hixio-mh/BatteryMeter/Images/3DPrint_PartsBottom.jpg

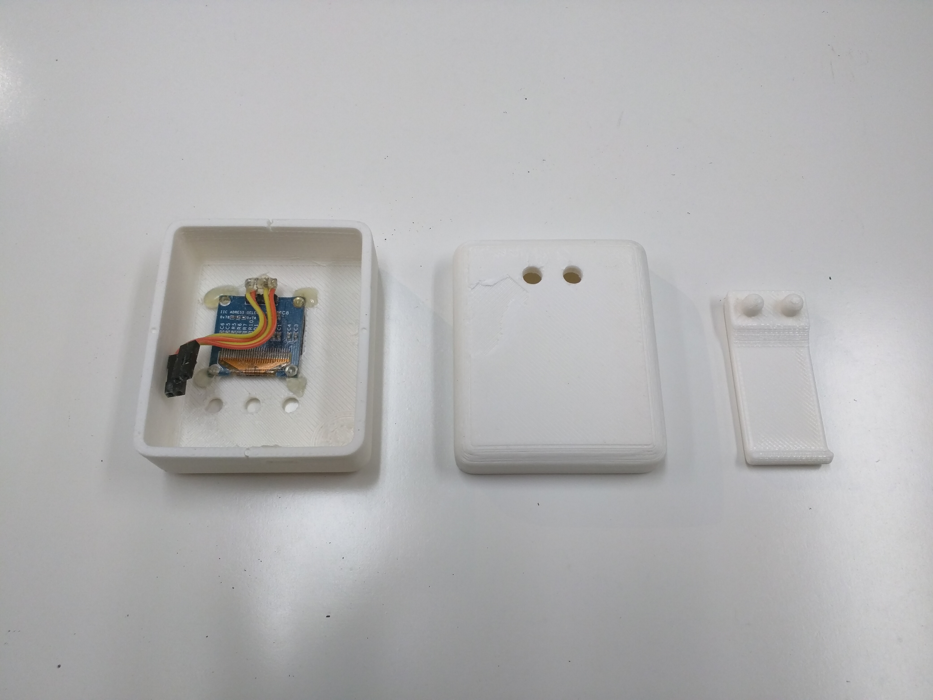
Images/3DPrint_PartsBottom.jpg
