hixio-mh/BatteryMeter/Images/PaperMockup_Bottom.jpg

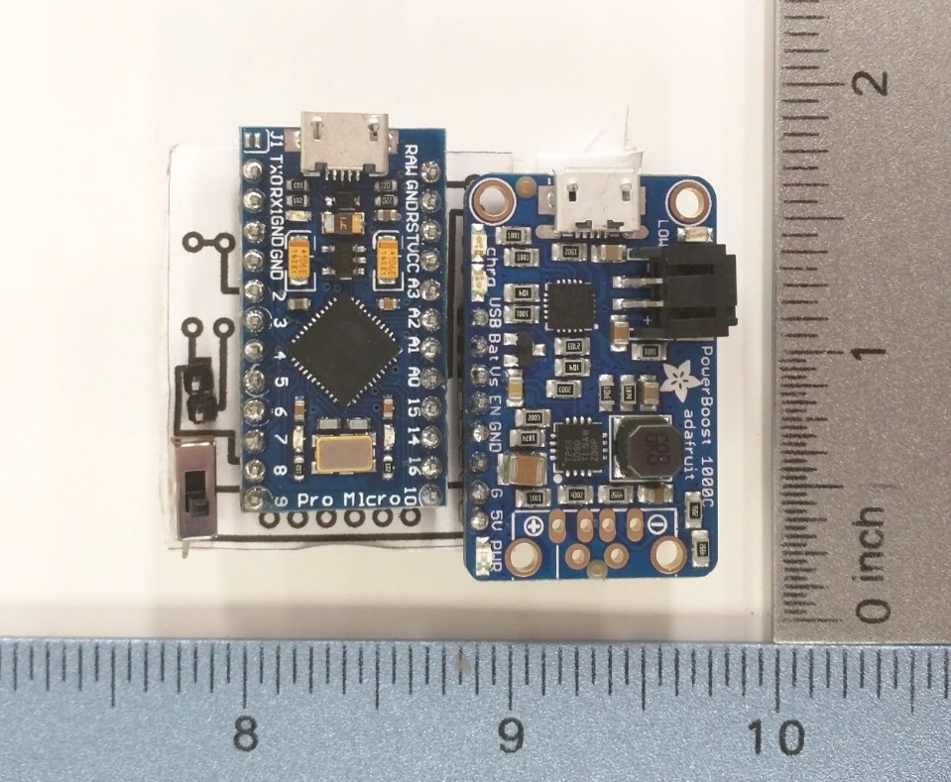
Images/PaperMockup_Bottom.jpg
