hixio-mh/BatteryMeter/README.md

# BatteryMeter
Battery Meter is a graphing voltmeter that allows users to track long-term performance of recharable batteries in handheld devices.
