hixio-mh/BatteryMeter/Documentation/07-FunctionProduction.pdf

### Function Production

Finalized Software
I have included the software in the GitHub repository with the following libraries:
- Adafruit GFX Library (modified)
- Adafruit ILI9341 Library
All code has been commented and I have included an appropriate license for the work.

Printed PCB

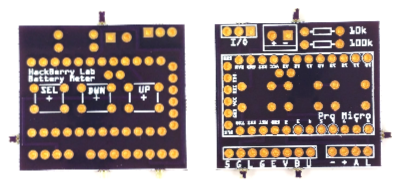
[picture p19: figure]
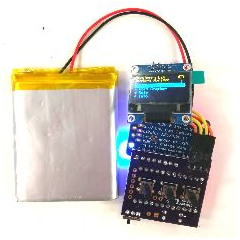
[picture p20: figure]
