hixio-mh/BatteryMeter/Documentation/08-FormProduction.pdf

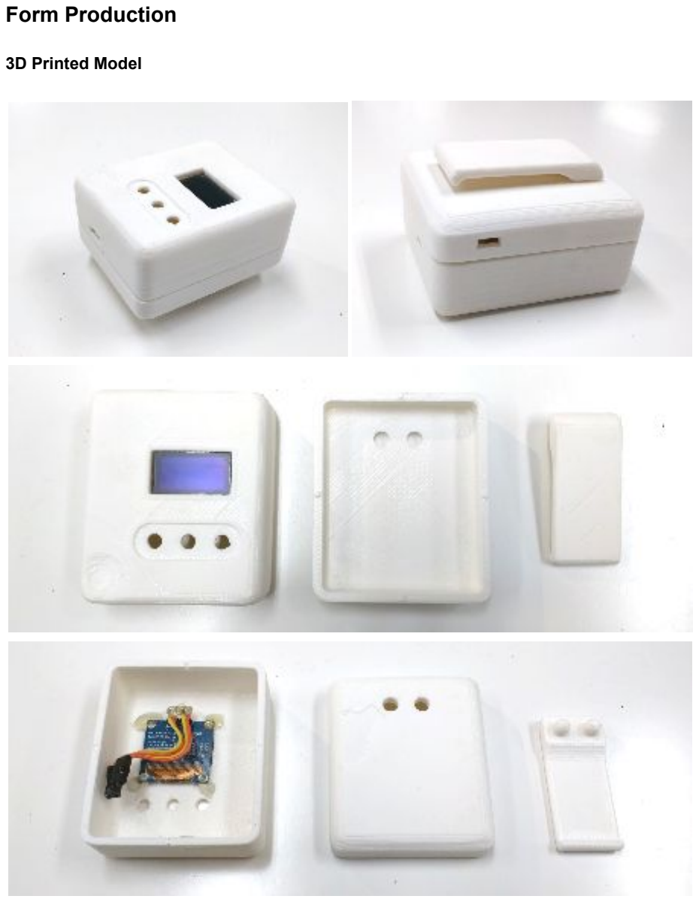
[picture p21: page 1]

### Form Production

3D Printed Model
