hixio-mh/BatteryMeter/Documentation/06-FormProof.pdf

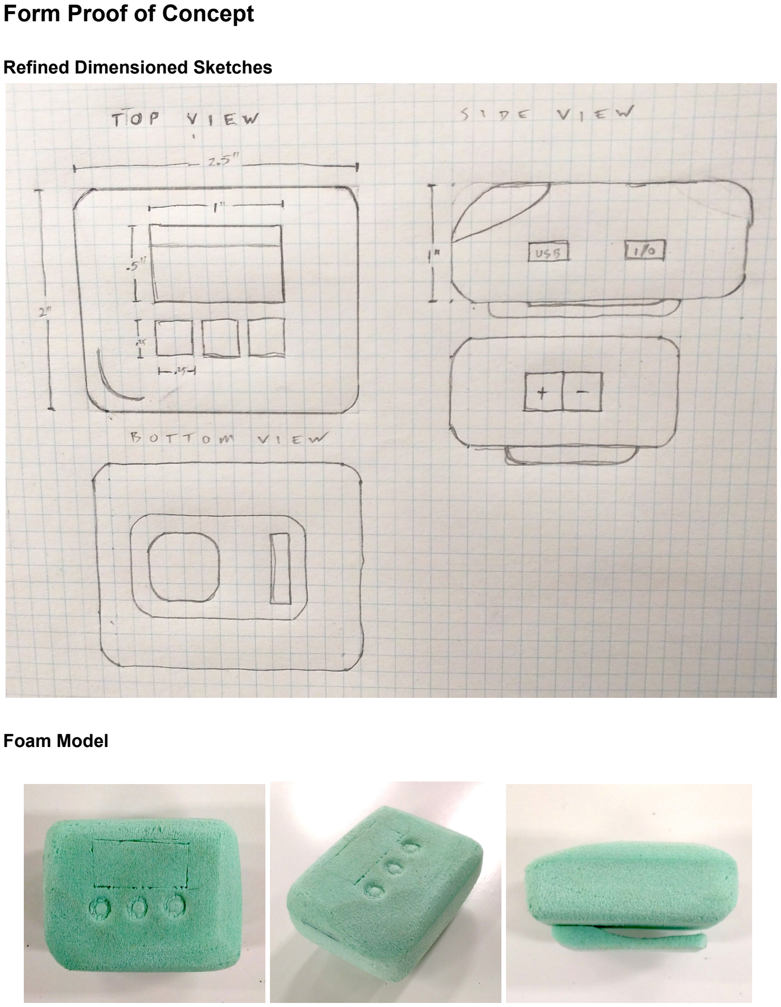
[picture p22: page 1]

### Form Proof of Concept

Refined Dimensioned Sketches

Foam Model

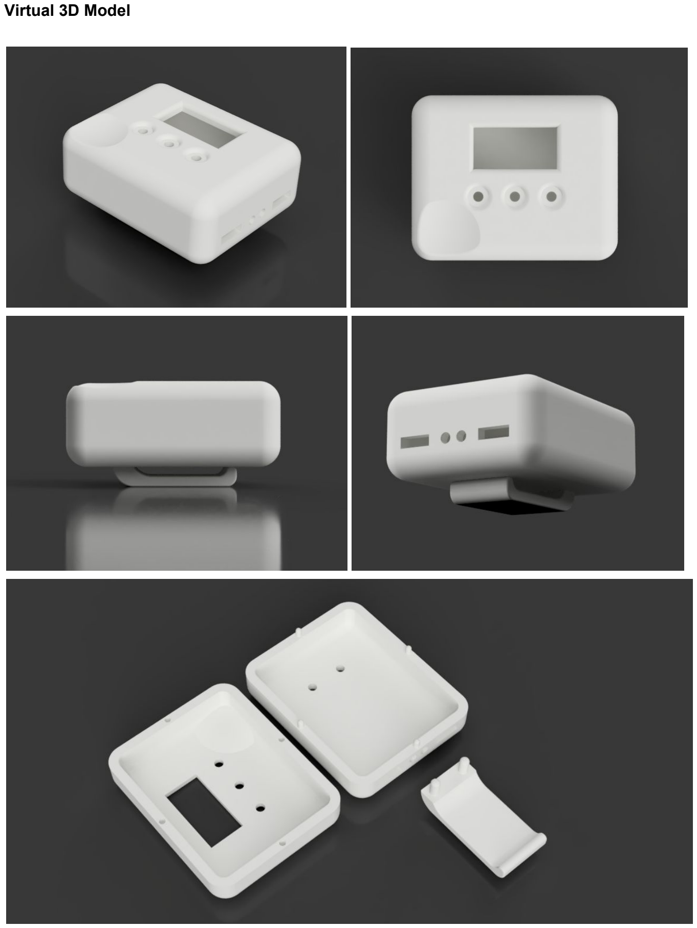
[picture p23: page 2]

Virtual 3D Model
