hixio-mh/BatteryMeter/Images/3DPrint_Bottom.jpg

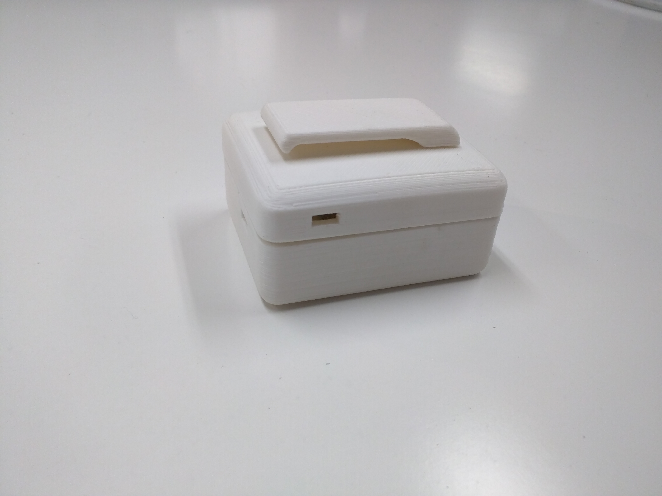
Images/3DPrint_Bottom.jpg
