hixio-mh/BatteryMeter/Images/3DPrint_Iso.jpg

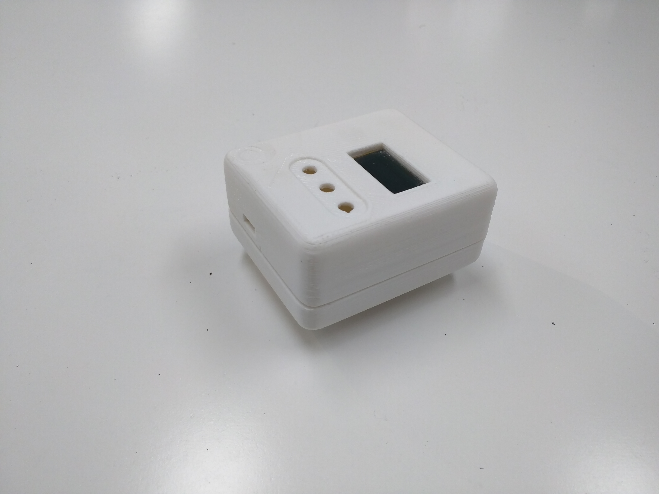
Images/3DPrint_Iso.jpg
