hixio-mh/BatteryMeter/Images/Concept2.jpg

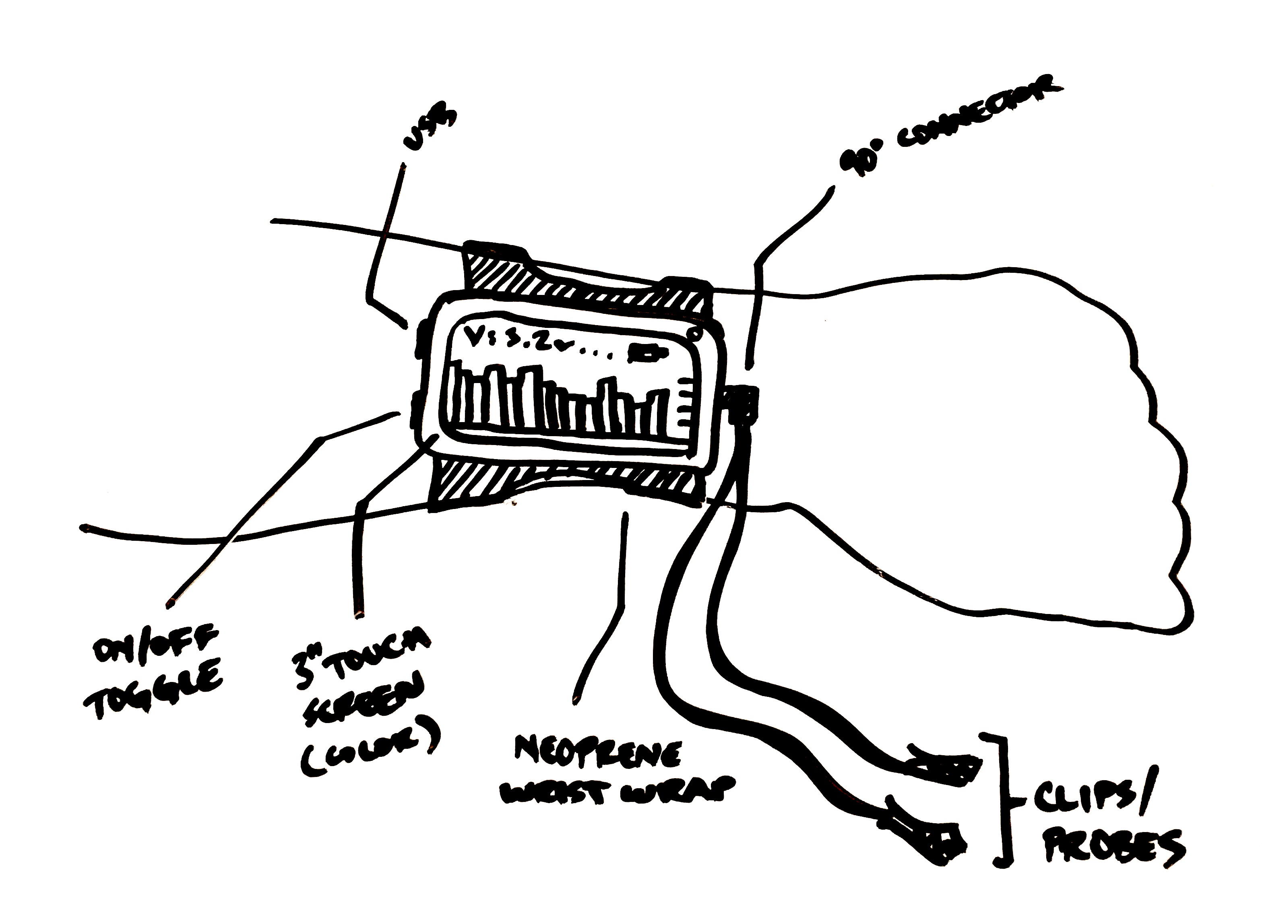
Images/Concept2.jpg
