hixio-mh/BatteryMeter/Images/Concept3.jpg

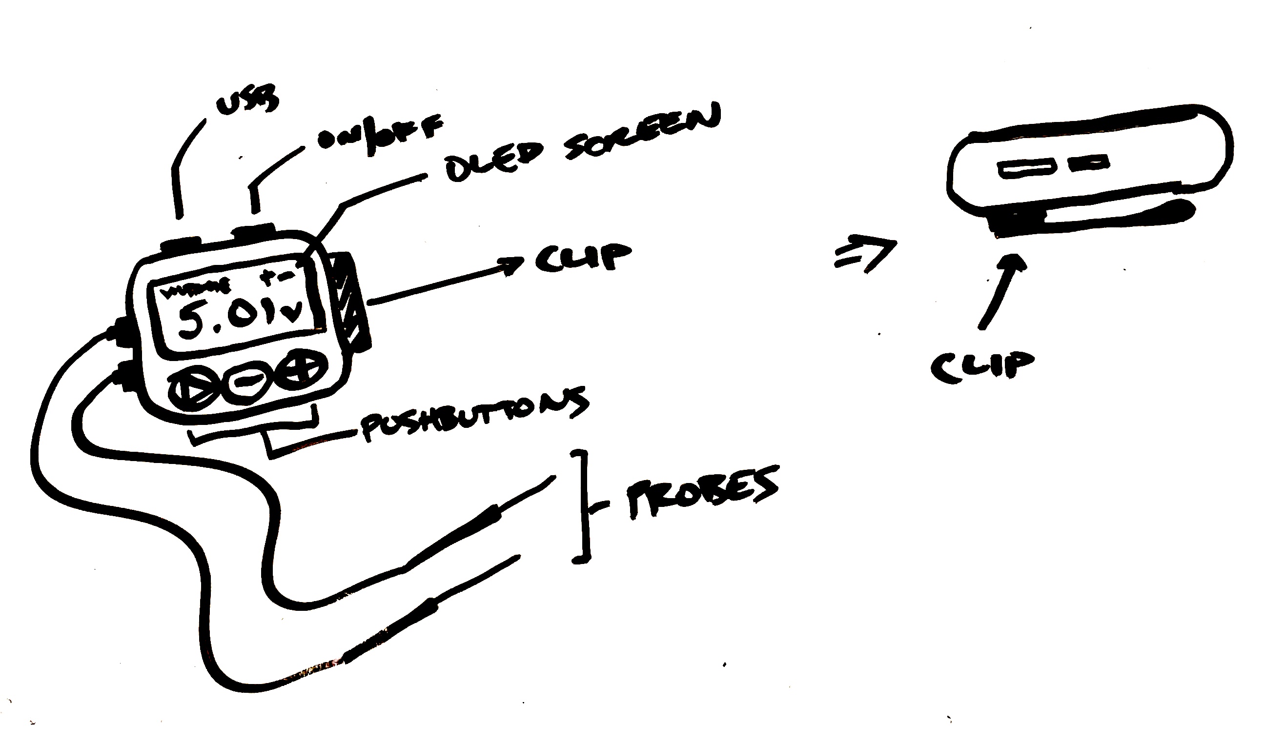
Images/Concept3.jpg
