hixio-mh/BatteryMeter/Images/Concept_Graph.png

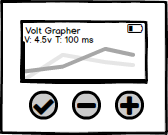
Images/Concept_Graph.png
