hixio-mh/BatteryMeter/Images/Concept_Home.png

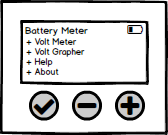
Images/Concept_Home.png
