hixio-mh/BatteryMeter/Images/Concept_Meter.png

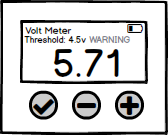
Images/Concept_Meter.png
