hixio-mh/BatteryMeter/Images/DimensionalDrawing.jpg

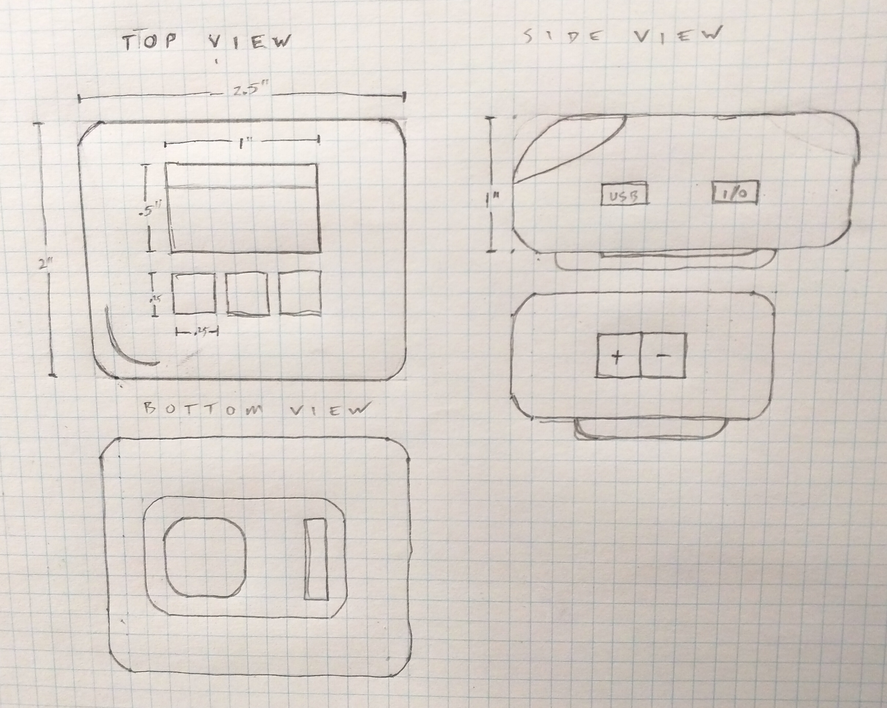
Images/DimensionalDrawing.jpg
