hixio-mh/BatteryMeter/Images/FoamIso.jpg

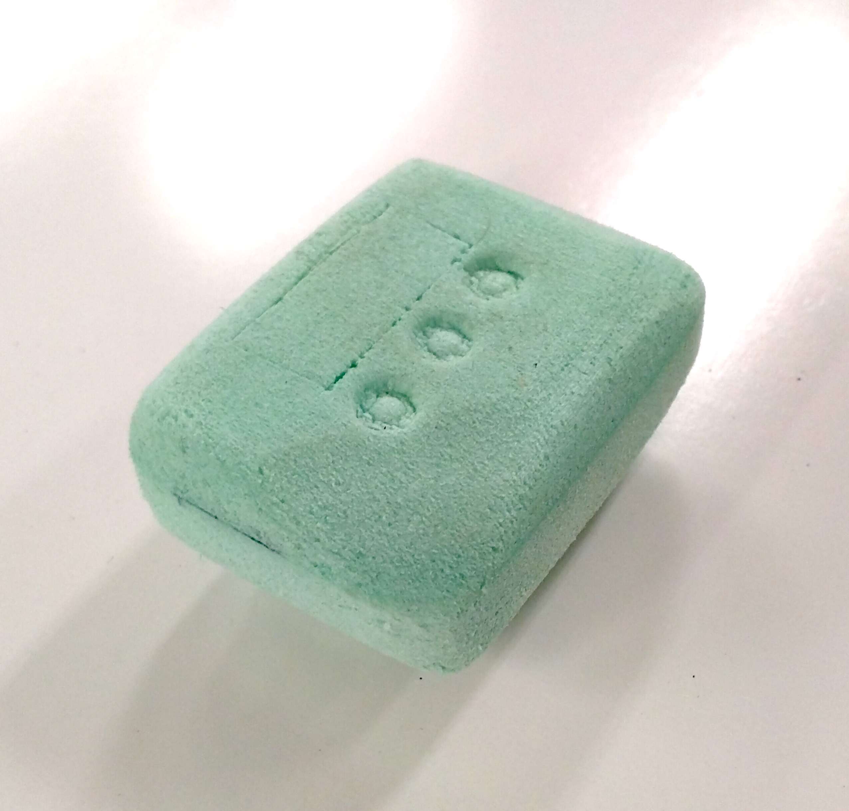
Images/FoamIso.jpg
