hixio-mh/BatteryMeter/Images/FoamSide.jpg

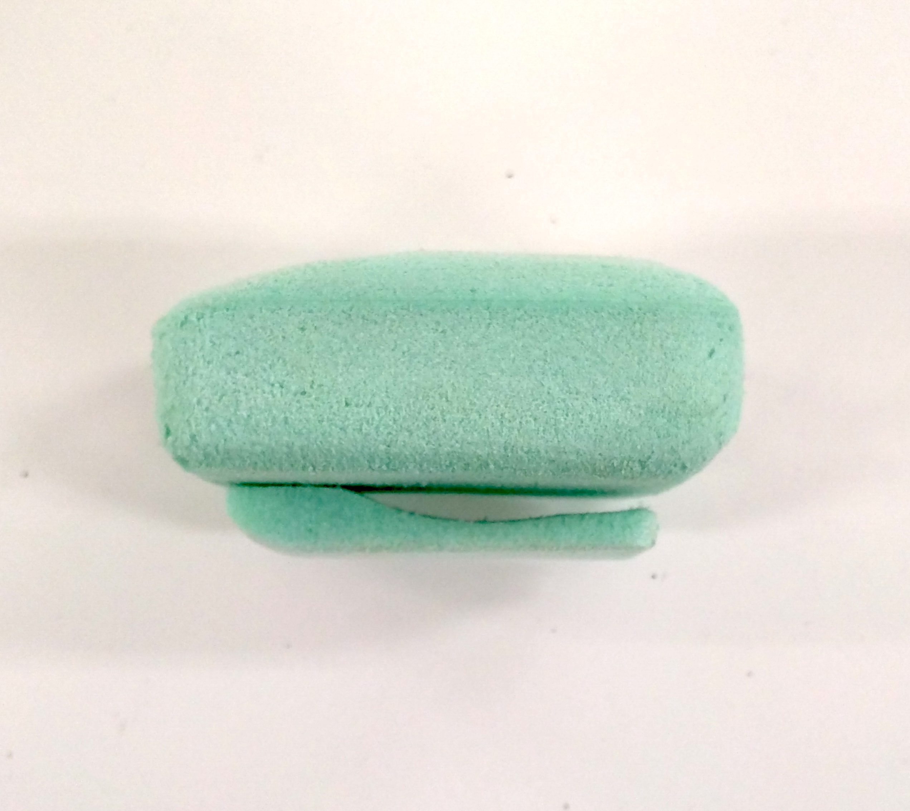
Images/FoamSide.jpg
