hixio-mh/BatteryMeter/Images/FoamTop.jpg

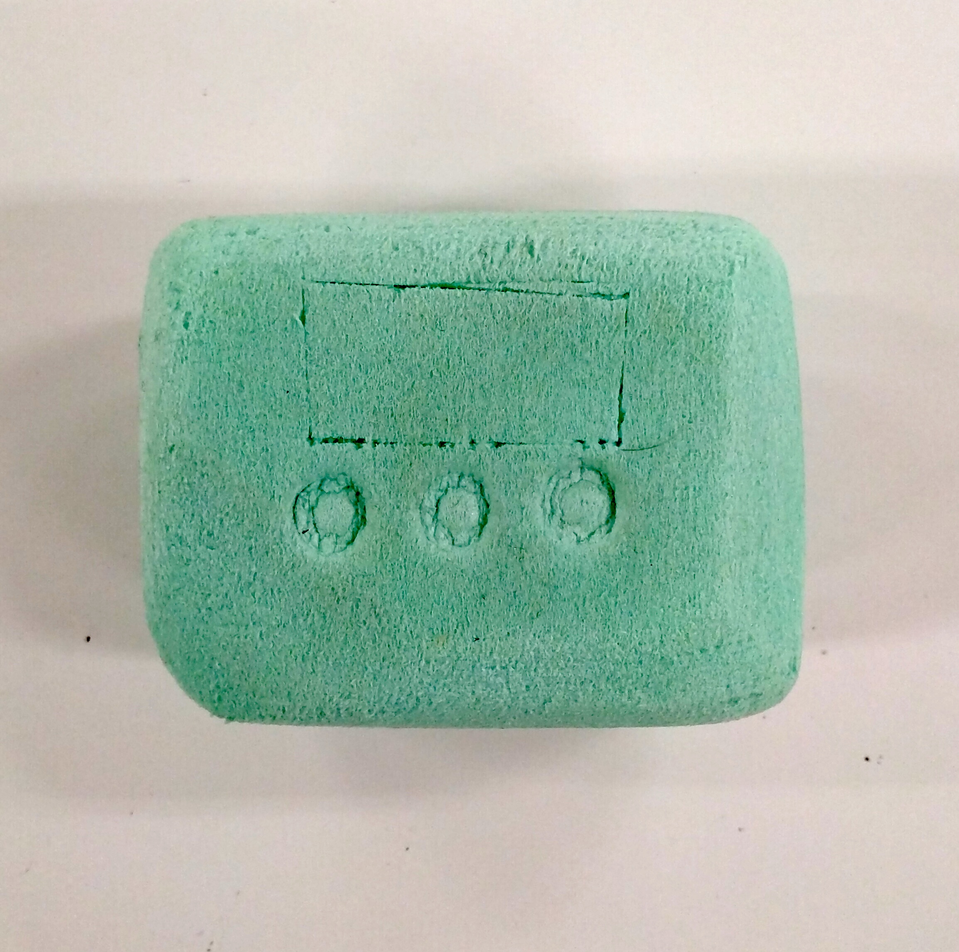
Images/FoamTop.jpg
