hixio-mh/BatteryMeter/Images/PaperMockup_Top.jpg

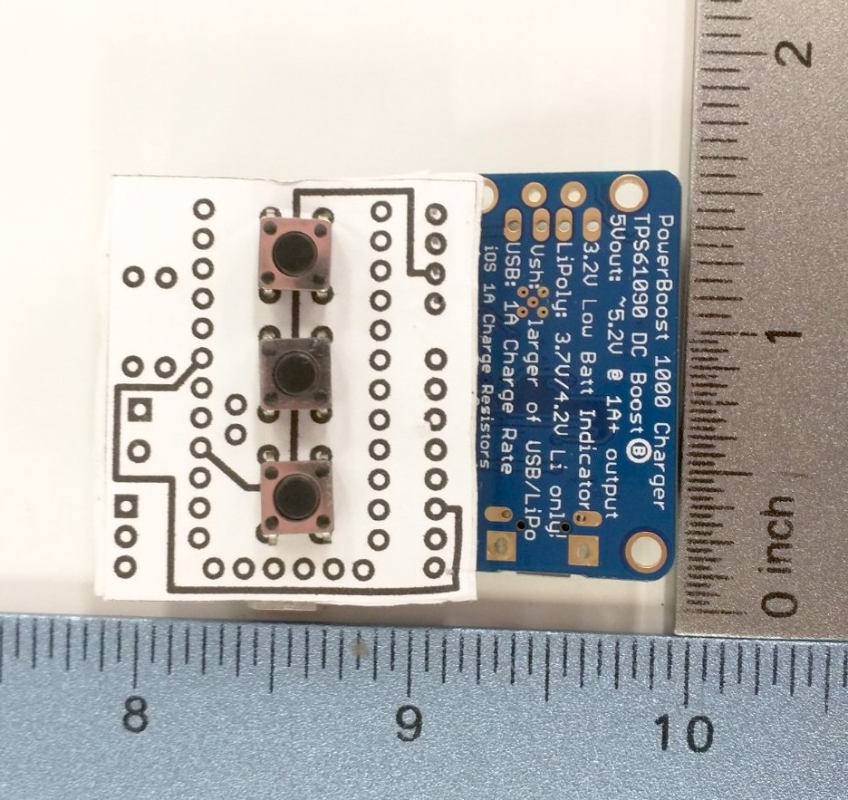
Images/PaperMockup_Top.jpg
