hixio-mh/BatteryMeter/Images/PCB_Bottom.jpg

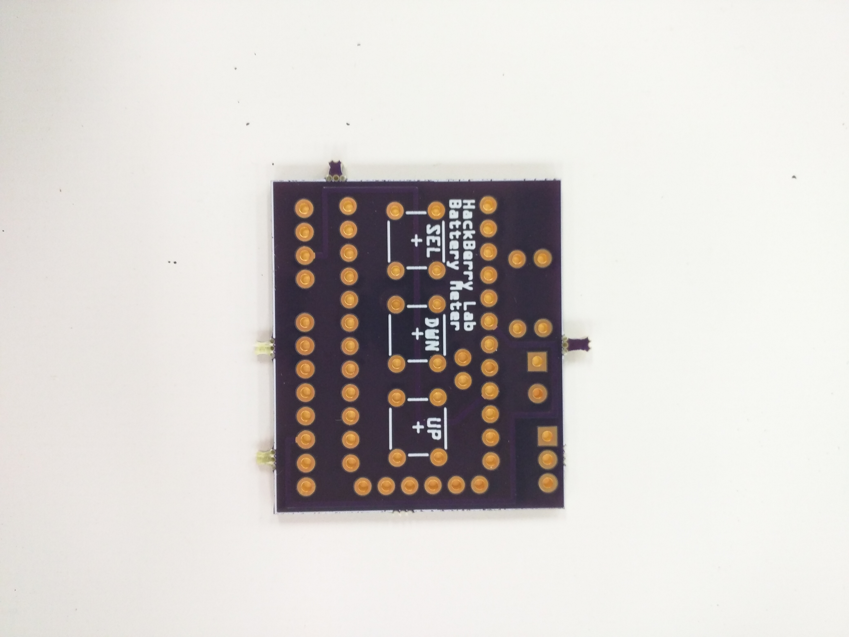
Images/PCB_Bottom.jpg
