hixio-mh/BatteryMeter/Images/PCB_Top.jpg

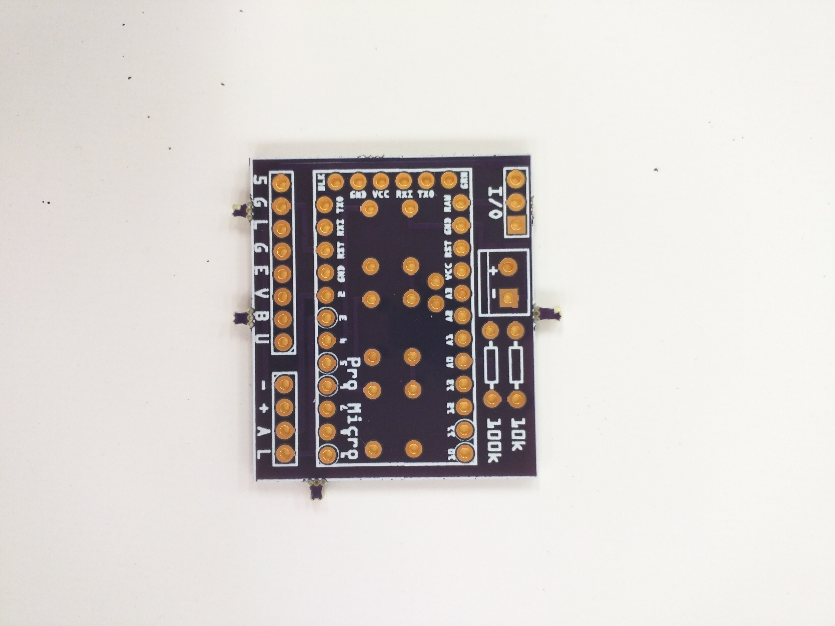
Images/PCB_Top.jpg
