hixio-mh/BatteryMeter/Images/Rendering_Bottom.png

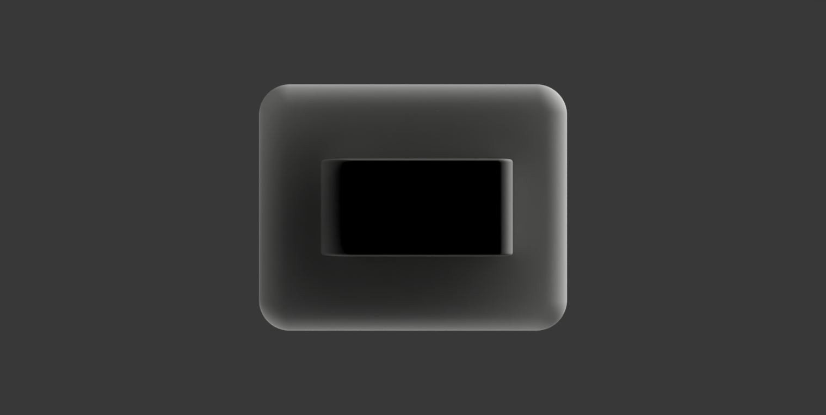
Images/Rendering_Bottom.png
