hixio-mh/BatteryMeter/Images/Rendering_Detail.png

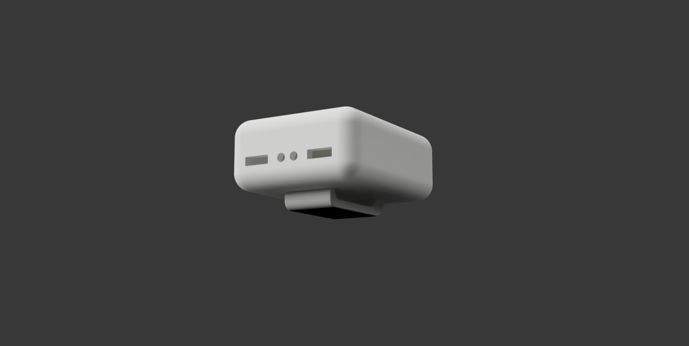
Images/Rendering_Detail.png
