hixio-mh/BatteryMeter/Images/Rendering_Exploded.png

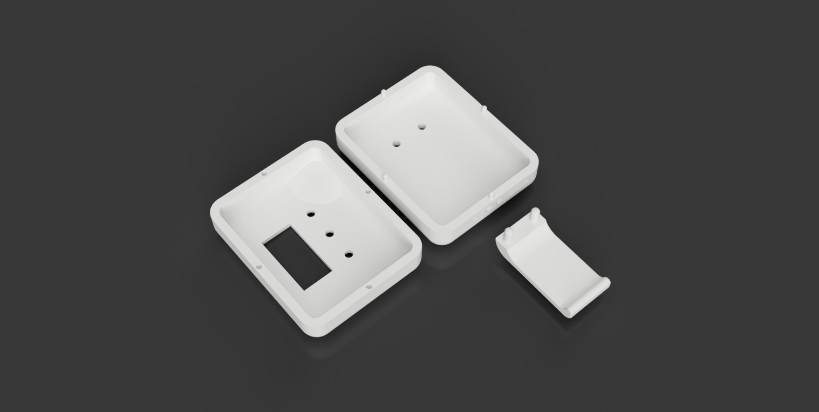
Images/Rendering_Exploded.png
