hixio-mh/BatteryMeter/Images/Rendering_ISO.png

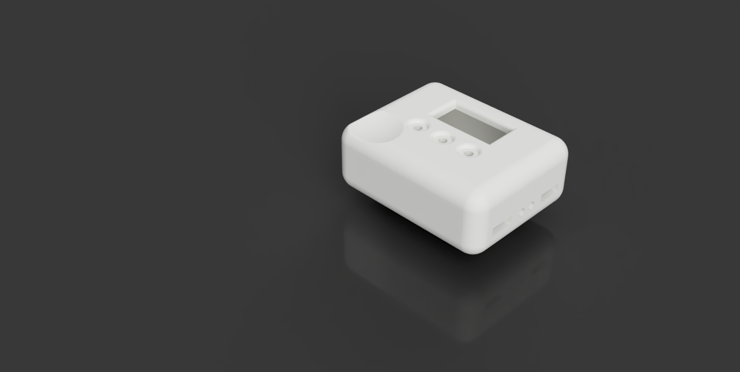
Images/Rendering_ISO.png
