hixio-mh/BatteryMeter/Images/Rendering_Side.png

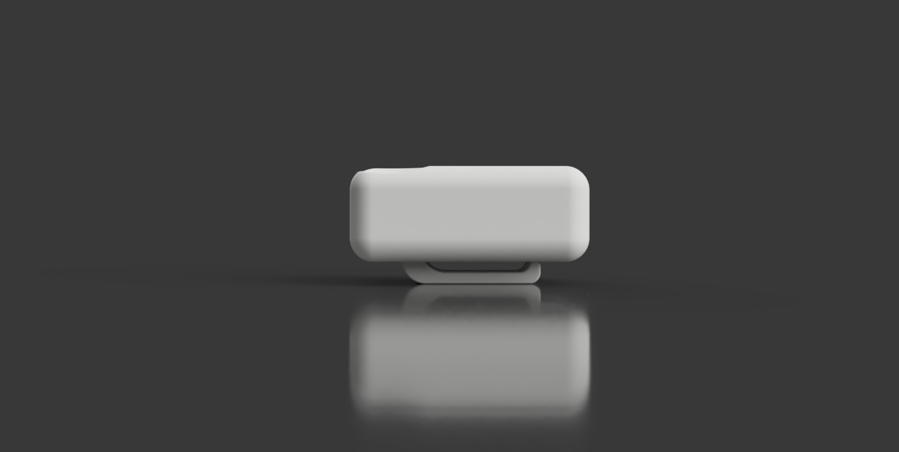
Images/Rendering_Side.png
