hixio-mh/BatteryMeter/Images/Rendering_Top.png

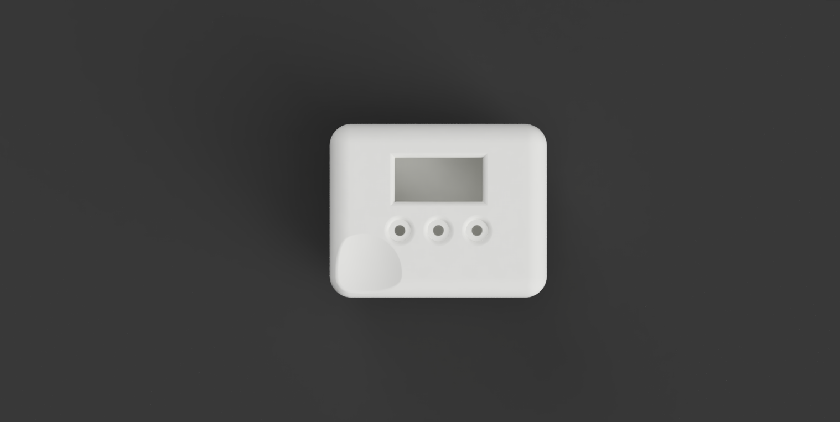
Images/Rendering_Top.png
