hixio-mh/BatteryMeter/Images/State_About.jpg

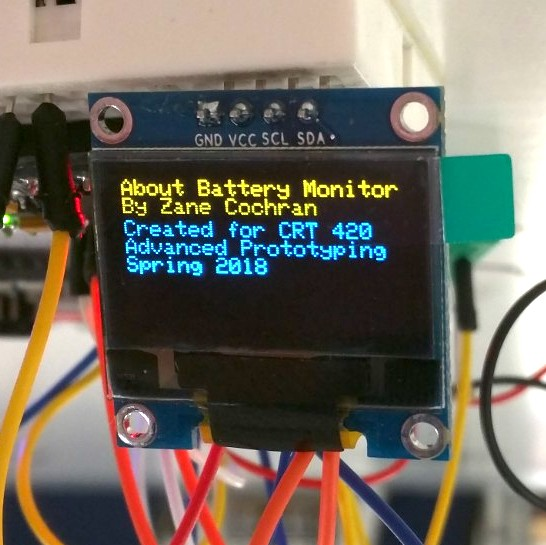
Images/State_About.jpg
