hixio-mh/BatteryMeter/Images/State_Graph.jpg

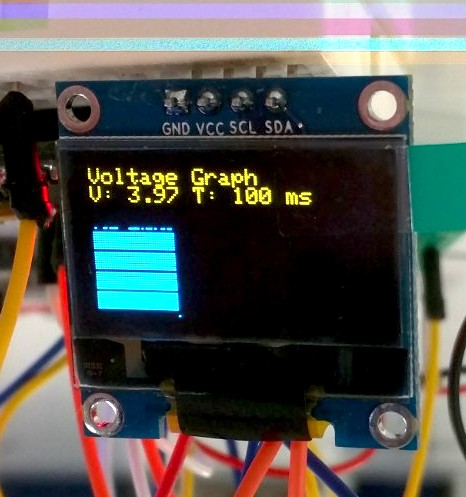
Images/State_Graph.jpg
