hixio-mh/BatteryMeter/Images/State_Help.jpg

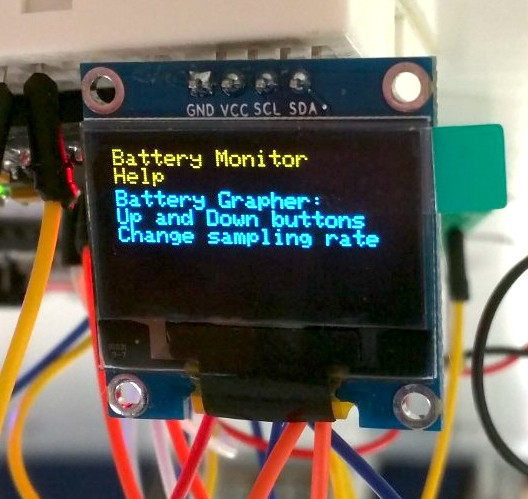
Images/State_Help.jpg
