hixio-mh/BatteryMeter/Images/State_Menu.jpg

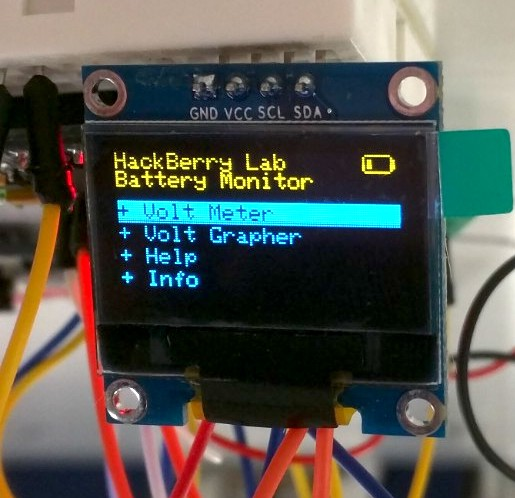
Images/State_Menu.jpg
