hixio-mh/BatteryMeter/Images/State_Meter.jpg

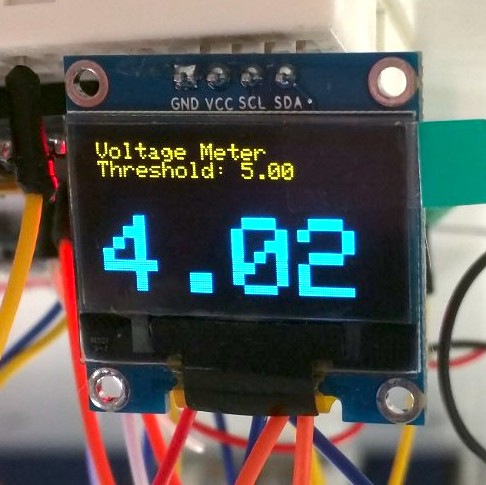
Images/State_Meter.jpg
