hixio-mh/BatteryMeter/PCB Files/Batter Checker PCB_pcb2.png

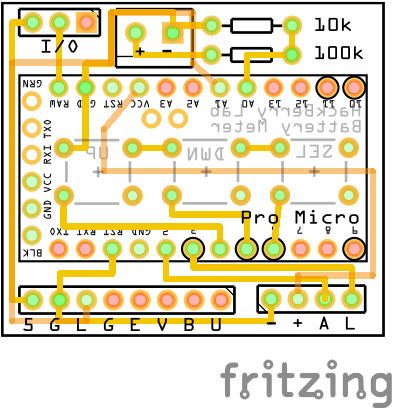
PCB Files/Batter Checker PCB_pcb2.png
