hixio-mh/BatteryMeter/PCB Files/Batter Checker PCB_pcb.png

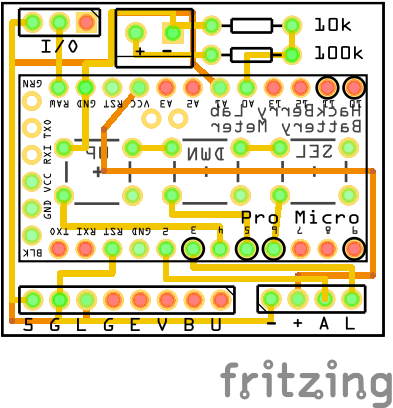
PCB Files/Batter Checker PCB_pcb.png
