hixio-mh/BatteryMeter/PCB Files/Battery Checker_bb.png

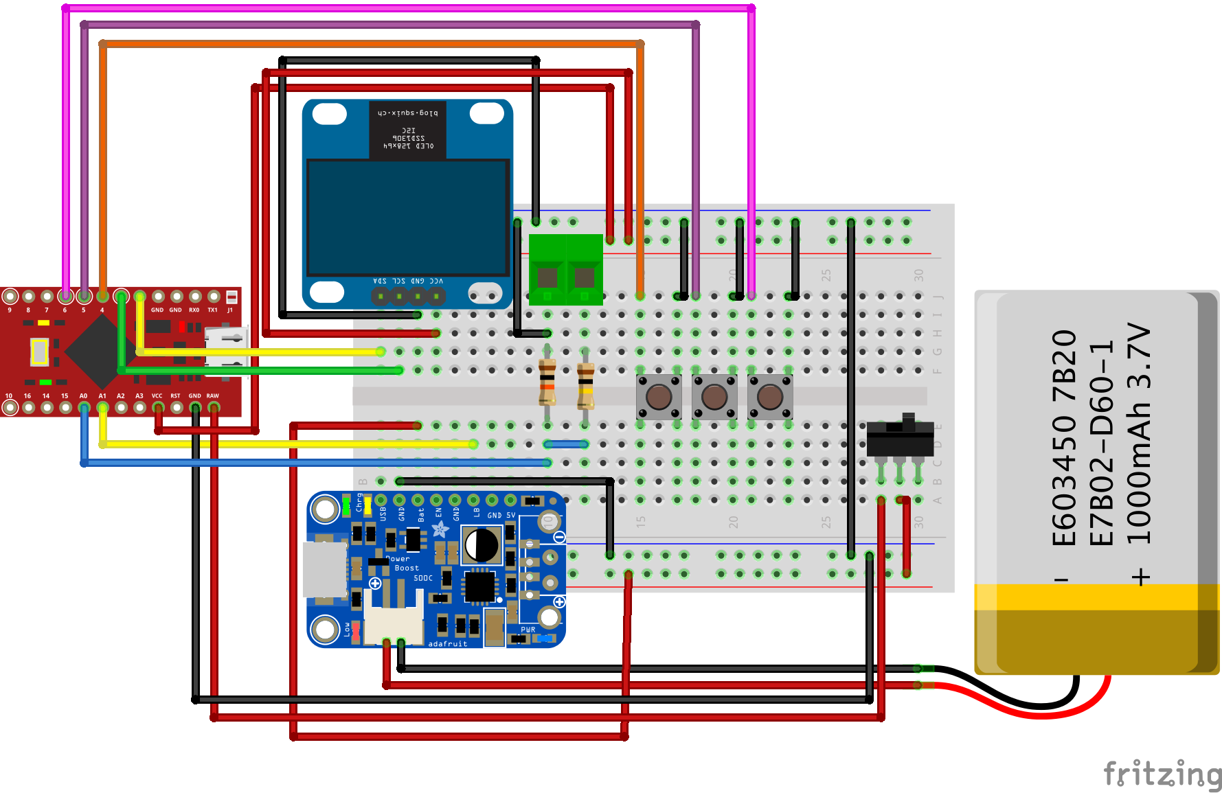
PCB Files/Battery Checker_bb.png
