hixio-mh/BatteryMeter/PCB Files/Battery Checker_schem.png

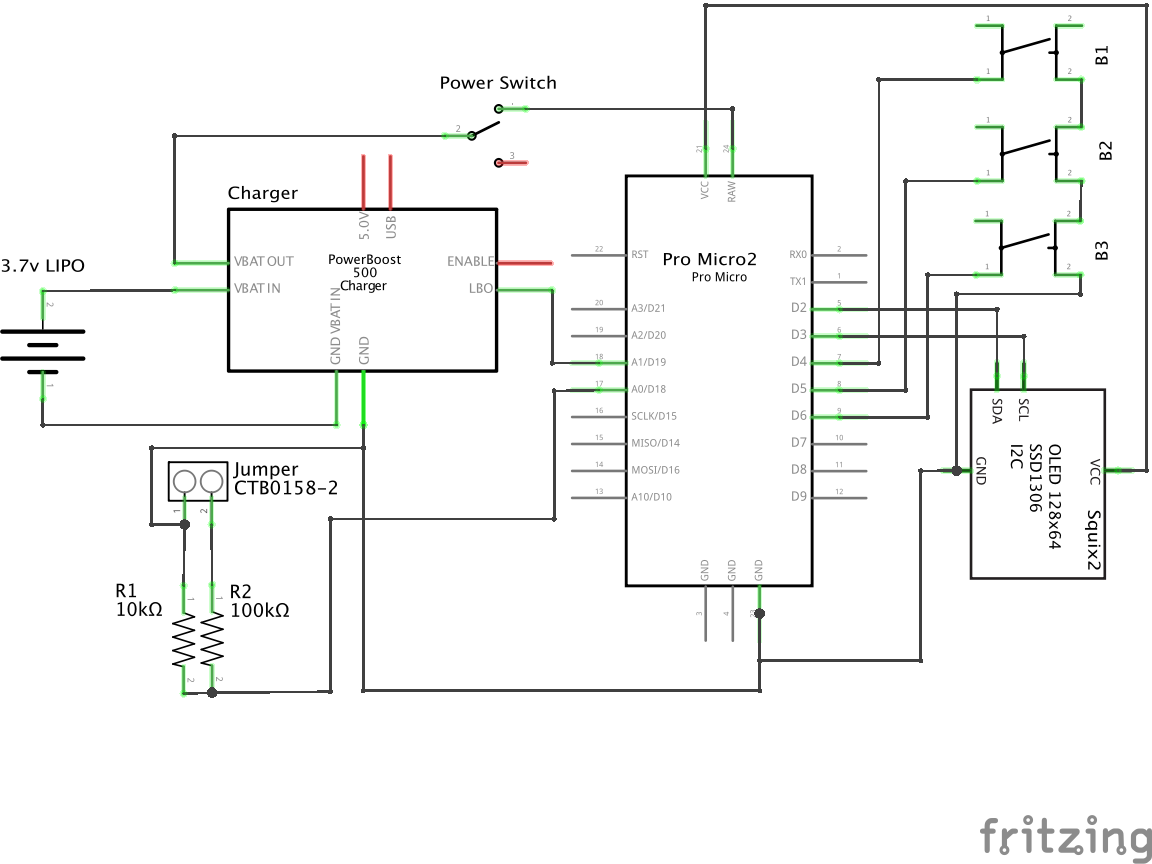
PCB Files/Battery Checker_schem.png
