hixio-mh/BatteryMeter/Images/3DPrint_PartsTop.jpg

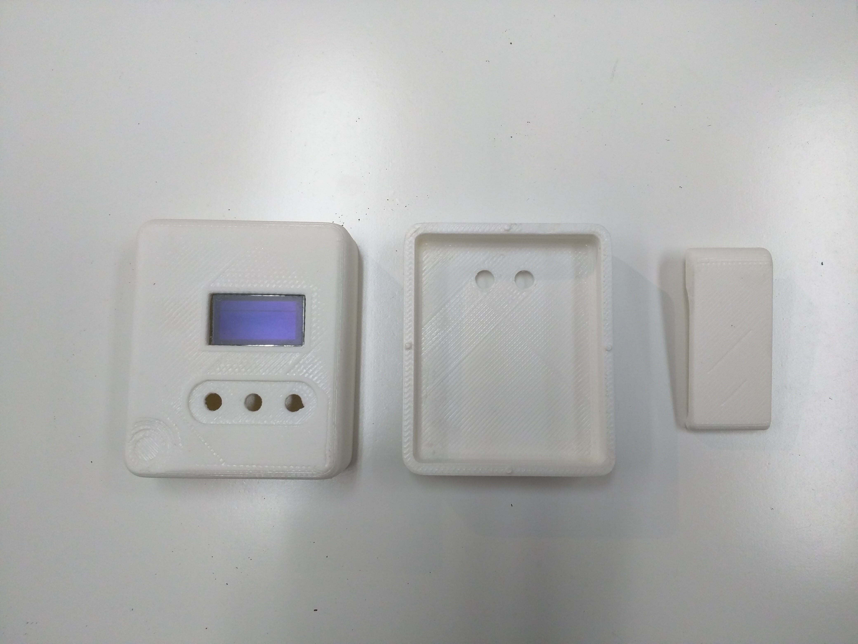
Images/3DPrint_PartsTop.jpg
