hixio-mh/BatteryMeter/Images/Breadboard_Assembled.jpg

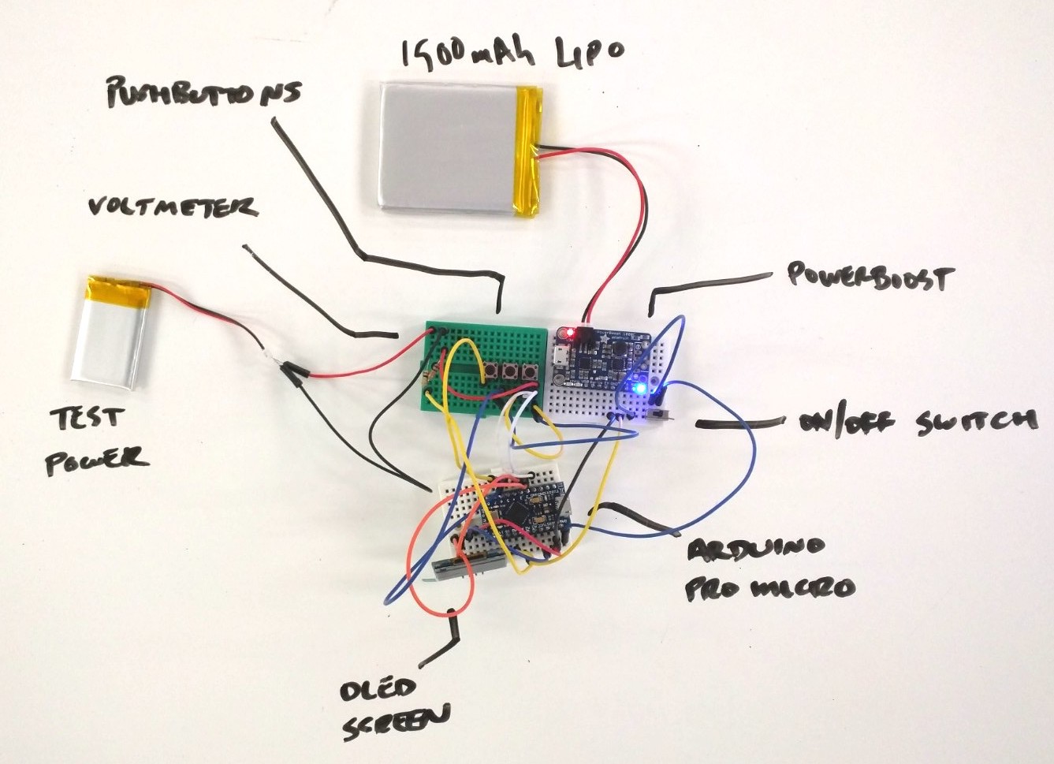
Images/Breadboard_Assembled.jpg
