hixio-mh/BatteryMeter/Images/PCB_Soldered.jpg

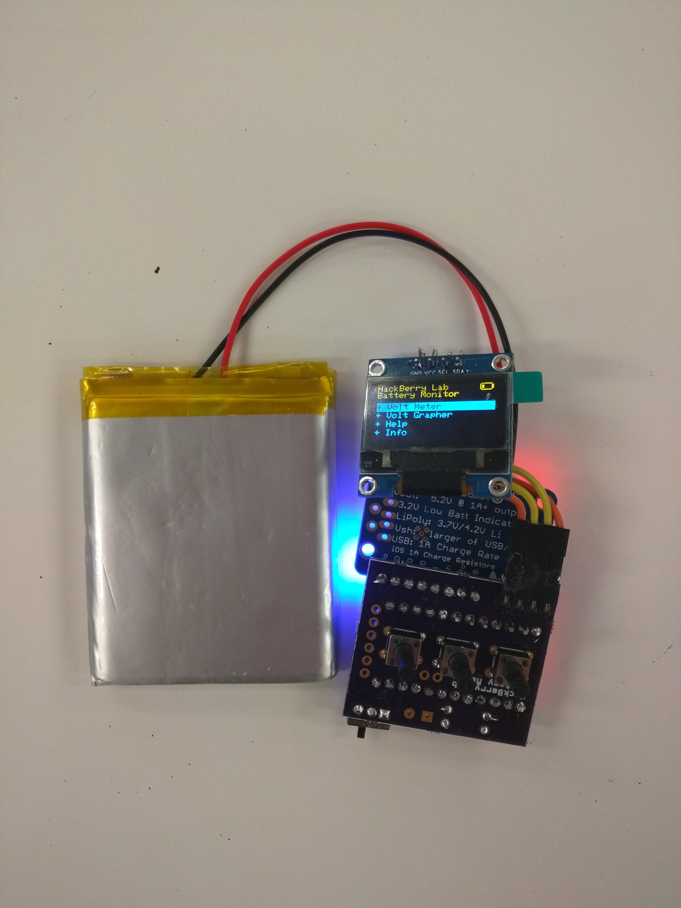
Images/PCB_Soldered.jpg
