hixio-mh/BatteryMeter/(list of files, drawings)

Other design files:
PCB Files/Batter Checker PCB.fzz
PCB Files/Battery Checker.fzz
