hixio-mh/BatteryMeter/Software/SmartMultimeter3/Display.ino

/* Handle Display Options */

// Initialize Display
void initDisplay(){
  display.begin(SSD1306_SWITCHCAPVCC, 0x3C);  // initialize with the I2C addr 0x3D (for the 128x64)
  display.display();
  delay(2000);
  display.clearDisplay();
}
